tursilion/skunk_pcbs/pcb3/pcb/usb-fx2-r2-bot.jpg

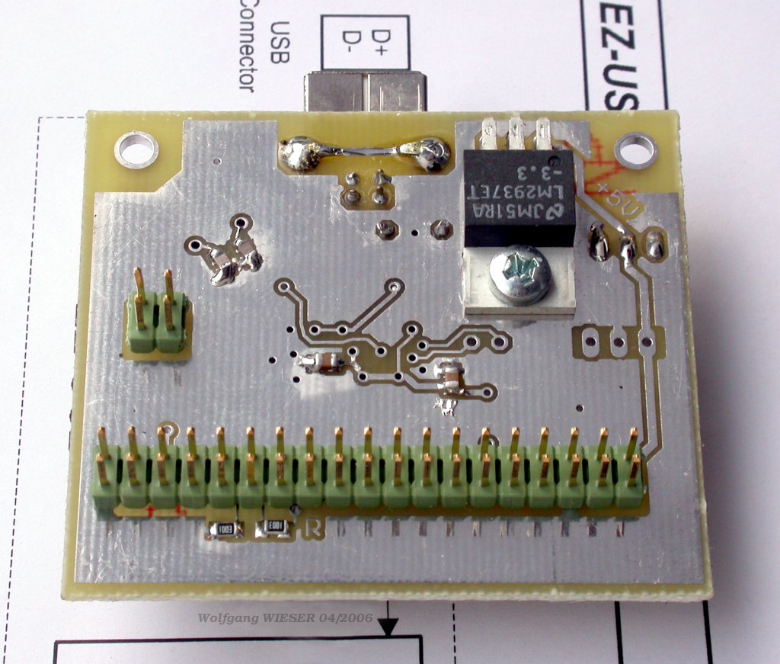
pcb3/pcb/usb-fx2-r2-bot.jpg
