tursilion/skunk_pcbs/pcb3/pcb/area-off/board_outline.png

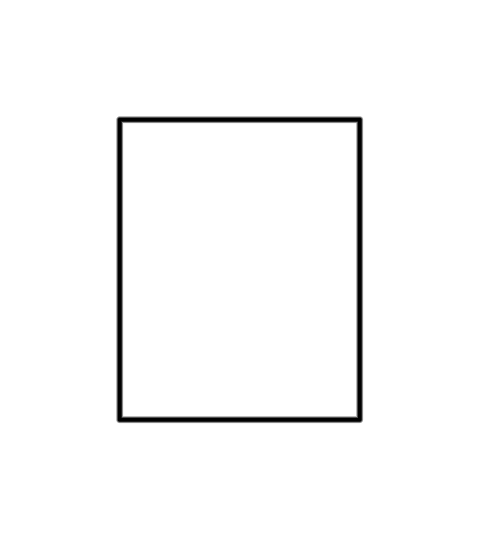
pcb3/pcb/area-off/board_outline.png
