tursilion/skunk_pcbs/pcb3/pcb/area-off/top_copper.png

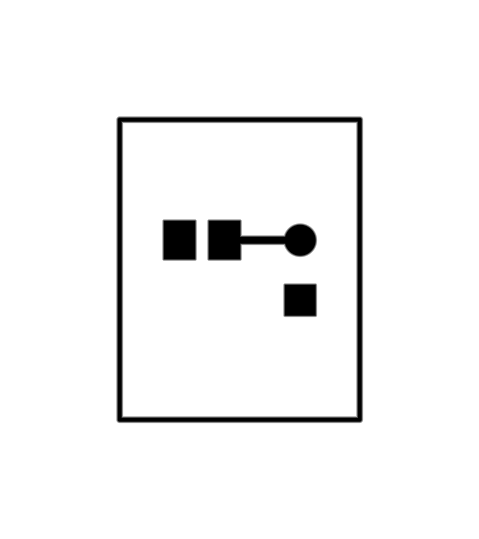
pcb3/pcb/area-off/top_copper.png
