tursilion/skunk_pcbs/pcb3/pcb/area-on/areaboardhouse.gif

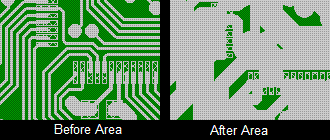
pcb3/pcb/area-on/areaboardhouse.gif
