tursilion/skunk_pcbs/pcb3/pcb/area-on/areaviewmate.gif

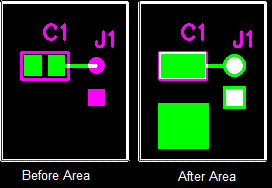
pcb3/pcb/area-on/areaviewmate.gif
