tursilion/skunk_pcbs/pcb3/pcb/area-on/top_copper.png

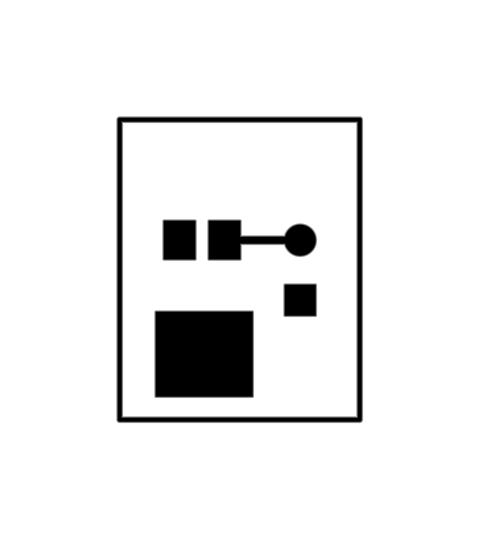
pcb3/pcb/area-on/top_copper.png
