tursilion/skunk_pcbs/pcb3/pcb/jagwave/CAM/board_outline.png

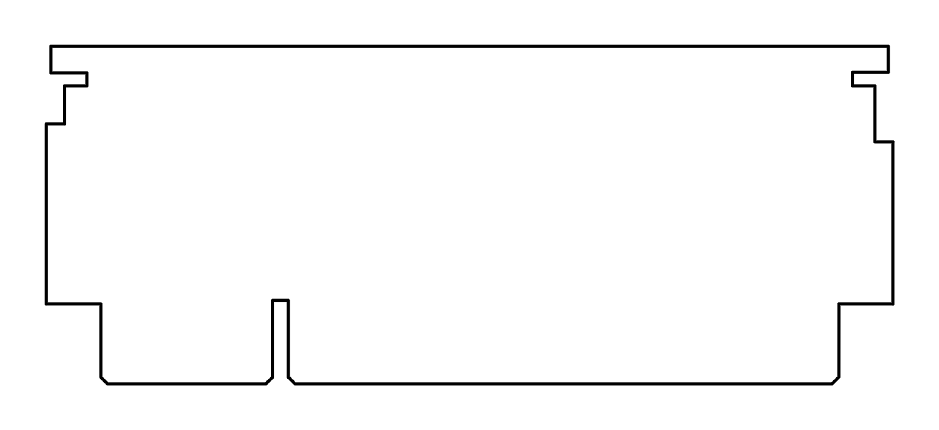
pcb3/pcb/jagwave/CAM/board_outline.png
