tursilion/skunk_pcbs/pcb3/pcb/jagwave/CAM/bottom_copper.png

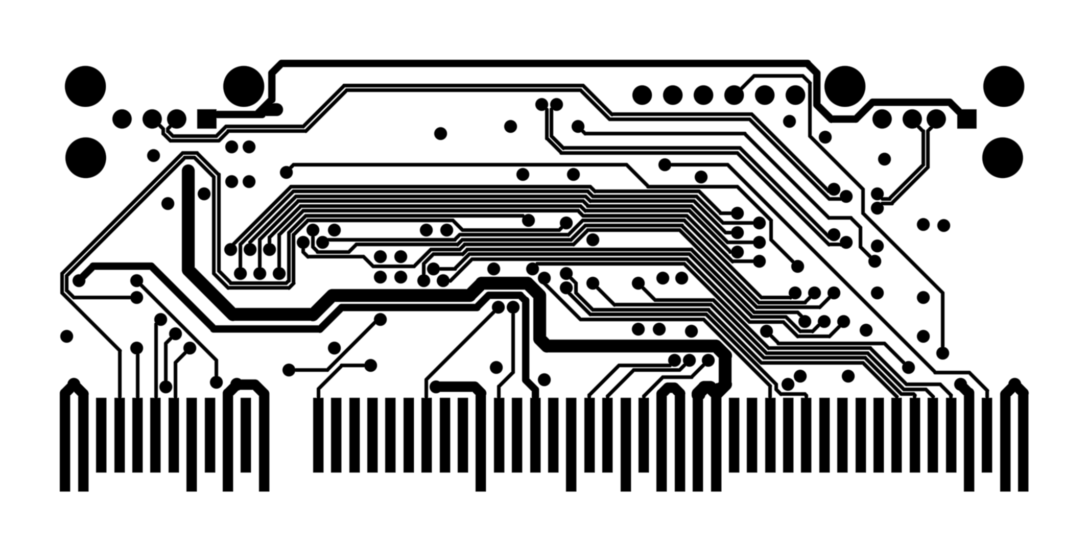
pcb3/pcb/jagwave/CAM/bottom_copper.png
