tursilion/skunk_pcbs/pcb3/pcb/jagwave/CAM/bottom_paste_mask.png

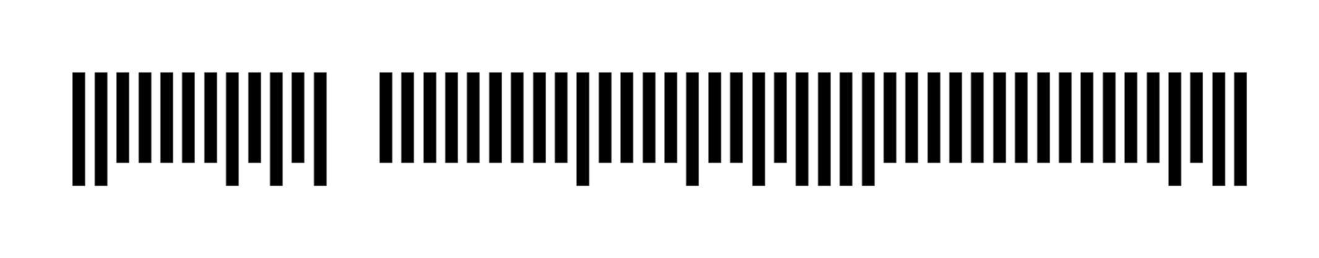
pcb3/pcb/jagwave/CAM/bottom_paste_mask.png
