tursilion/skunk_pcbs/pcb3/pcb/jagwave/CAM/bottom_silk.png

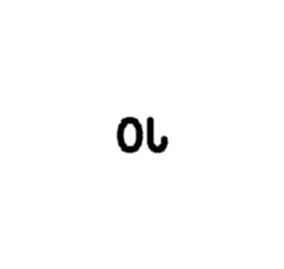
pcb3/pcb/jagwave/CAM/bottom_silk.png
