tursilion/skunk_pcbs/pcb3/pcb/jagwave/CAM/inner_copper_2.png

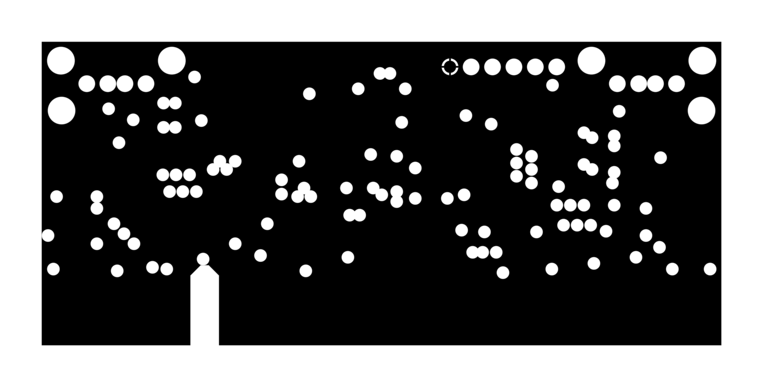
pcb3/pcb/jagwave/CAM/inner_copper_2.png
