tursilion/skunk_pcbs/pcb3/pcb/jagwave/CAM/top_copper.png

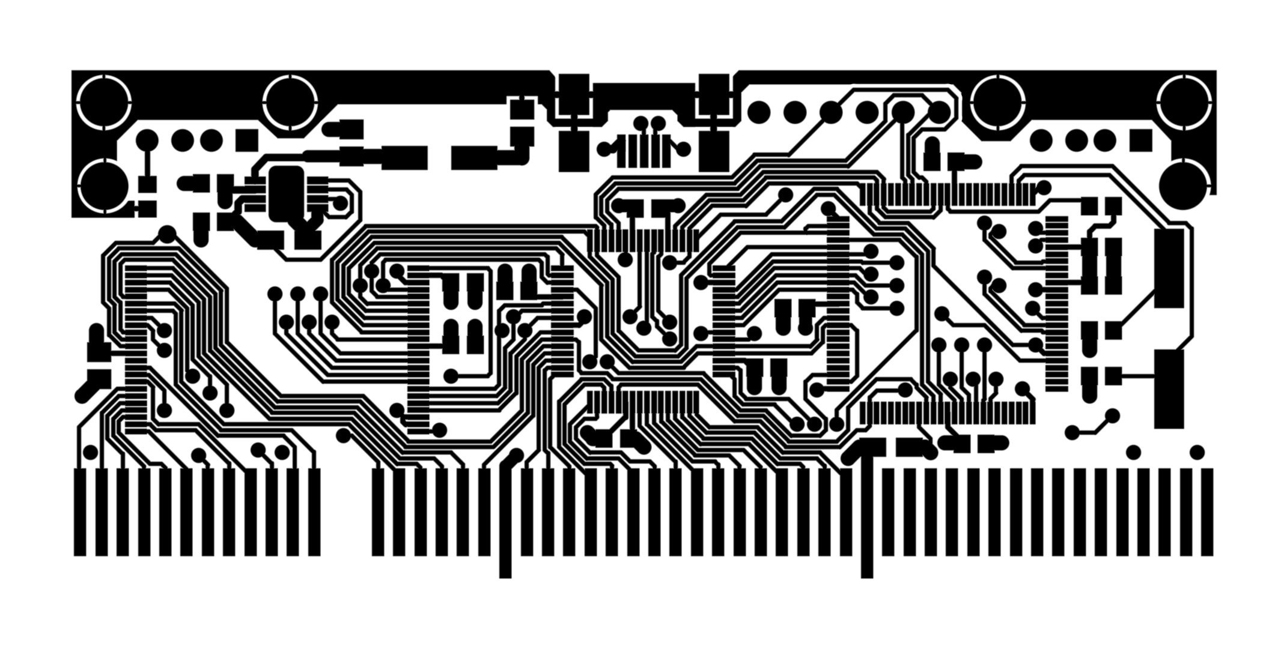
pcb3/pcb/jagwave/CAM/top_copper.png
