tursilion/skunk_pcbs/pcb3/pcb/jagwave/CAM/top_paste_mask.png

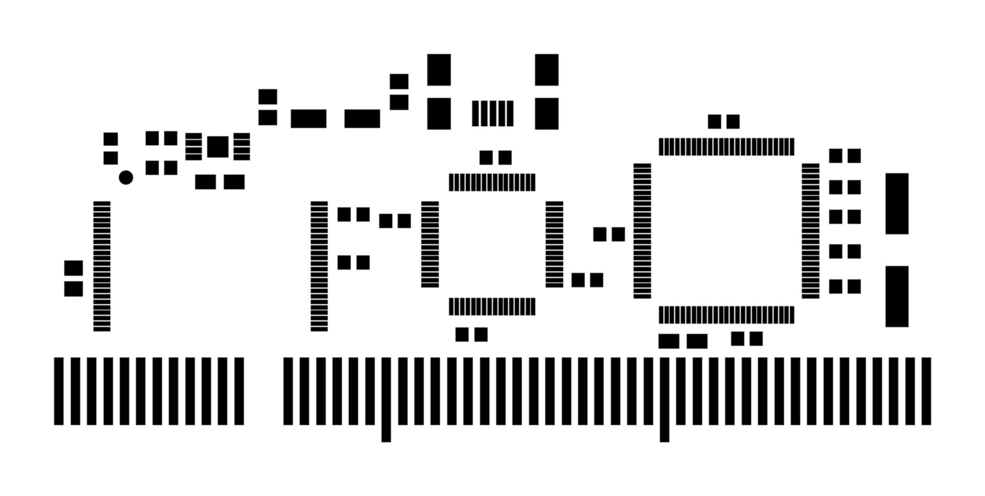
pcb3/pcb/jagwave/CAM/top_paste_mask.png
