tursilion/skunk_pcbs/pcb3/pcb/jagwave/CAM/top_silk.png

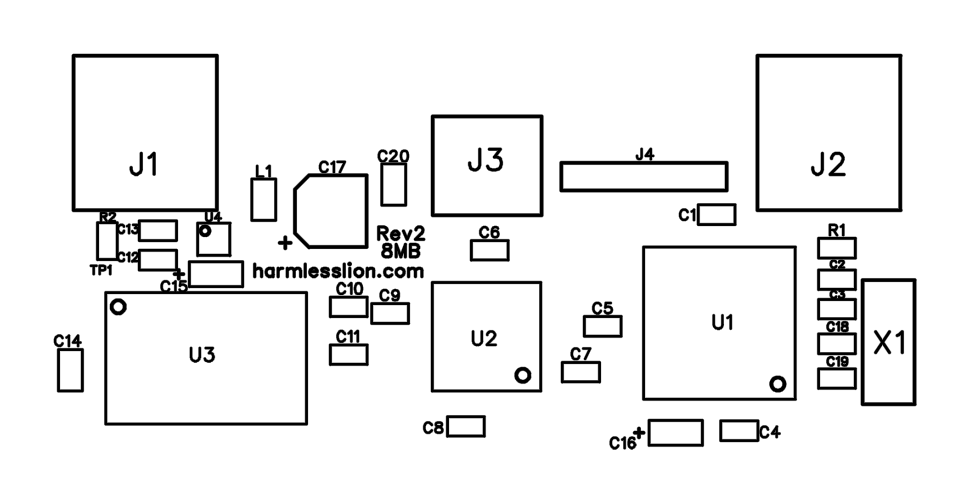
pcb3/pcb/jagwave/CAM/top_silk.png
