tursilion/skunk_pcbs/pcb3/bom.xls

Reference | Qty | Package | Description | DigiKey Part Number | Mfr Part Number | Available | Price (@100) | Needed | Total |  | Already Got | Digikey | Mouser | ACTUAL
DIGIKEY
C1-C13 | 13 | C0603 | CAP CER .1UF 16V 10% X7R 0603 | 490-1532-1-ND | GRM188R71C104KA01D | 646748 | $1.04 | 1300
 | 13 | C0603 | CAP CER .1UF 16V 10% X7R 0603 | 81-GRM39X104K16 | GRM188R71C104KA01D | 758856 | $2.40 | 1300 | $31.20 | Mouser |  |  | $14.63 | $14.63
C14 | 1 | C0805 | CAP CERAMIC 1UF 25V X5R 0805 | PCC2319CT-ND | ECJ-2FB1E105K | 0 |  |  |  | Cross Reference: Mfr: C2012X5R1E105K
 |  |  |  | 445-1419-1-ND | C2012X5R1E105K | 339280 | $9.75 | 100 |  | Thinner, otherwise looks the same
 | 1 | C0805 | CAP CERAMIC 1UF 25V X5R 0805 | 810-C2012X5R1E105K | ECJ-2FB1E105K | 31108 | $9.70 | 100 | $9.70 | Mouser |  |  | $18.48 | $18.48
C15, C16 | 2 | CAP-TANT-A | CAP TANTALUM 10UF 16V 10% SMD | 495-2236-1-ND | B45196H3106K109 | 468976 | $29.70 | 200
 | 2 | CAP-TANT-A | CAP TANTALUM 10UF 16V 10% SMD | 80-B45196H3106K109 | B45196H3106K109 | 112519 | $17.80 | 200 | $35.60 | Mouser |  |  | $41.14 | $41.14
C17 | 1 | CAP-SMT-CAN-D | CAP 150UF 10V ELECT MVA SMD | 565-2076-1-ND | EMVA100ADA151MF55G | 0 |  |  |  | Cross Reference: Mfr: EEE-FK1A151P
 |  |  |  | PCE3773CT-ND | EEE-FK1A151P | 231640 | $30.41 | 100 |  | Taller + different specs! RE-CHECK DATASHEET!
 | 1 | CAP-SMT-CAN-D | CAP 150UF 10V ELECT MVA SMD | 667-EEE-FK1A151P | EMVA100ADA151MF55G | 2200 | $23.80 | 100 | $23.80 | Mouser (slightly more, but original part) |  |  | $40.37 | $40.37
C18, C19 | 2 | C0603 | CAP CERAMIC 22PF 50V 0603 SMD | PCC220ACVCT-ND | ECJ-1VC1H220J | 0 |  |  |  | Cross Reference: Mfr: 06035A220JAT2A
 |  |  |  | 478-1167-1-ND | 06035A220JAT2A | 208810 | $4.23 | 200
 | 2 | C0603 | CAP CERAMIC 22PF 50V 0603 SMD | 581-06035A220J | ECJ-1VC1H220J | 57150 | $2.00 | 200 | $4.00 | Mouser |  |  | $14.52 | $14.52
C20 | 1 | C0805 | CAP CER 4700PF 250V X7R 10% 0805 | 445-2279-1-ND | C2012X7R2E472K | 66600 | $9.10 | 100
 | 1 | C0805 | CAP CER 4700PF 250V X7R 10% 0805 | 810-C2012X7R2E472K | C2012X7R2E472K | 11960 | $9.70 | 100 | $9.70 | Mouser |  |  | $19.25 | $19.25
J1, J2 | 2 | USB-A PTH | CONN RCPT USB TYPE A R/A PCB | 609-1045-ND | 87520-0010BLF | 32136 | $43.10 | 200
 | 2 | USB-A PTH | CONN RCPT USB TYPE A R/A PCB | 649-87520-0010BLF | 87520-0010BLF | 2265 | $43.00 | 200 | $86.00 | Mouser |  |  | $90.20 | $90.20
J3 | 1 | MINIUSB-B SMD | CONN RECEPT MINIUSB R/A 5POS SMD | WM17116CT-ND | 54819-0572 | 20495 | $96.57 | 100 | $96.57 |  |  | $127.80 |  | $127.80
J4 | 1 | MOLEX 6 POS PTH | CONN HEADER 6POS .100 VERT TIN | WM4004-ND | 22-03-2061 | 6677 | $36.90 | 0 |  | Do not stuff
L1 | 1 | C0805 | FERRITE 800MA 120 OHM 0805 SMD | 240-2383-1-ND | LI0805H121R-10 | 385620 | $6.00 | 100 | $6.00 |  |  | $13.60 |  | $13.60
R1 | 1 | C0603 | RES 47K OHM 1/10W 5% 0603 SMD | P47KGCT-ND | ERJ-3GEYJ473V | 2269826 | $0.79 | 100 | $0.79 |  |  | $7.60 |  | $7.60
R2 | 1 | C0805 | RES 1.0M OHM 1/10W 5% 0603 SMD | 541-1.0MGCT-ND | CRCW06031M00JNEA | 90330 | $4.00 | 100
 | 1 | C0805 | RES 1.0M OHM 1/10W 5% 0603 SMD | 71-CRCW0603J-1.0M-E3 | CRCW06031M00JNEA | 70408 | $2.00 | 100 | $2.00 | Mouser |  |  | $9.46 | $9.46
 | 1 | QFP-100-.5-16.0X16.0 | IC USB HOST/PERIPH CNTRL 100TQFP | 428-1865-ND | CY7C67300-100AXI | 267 | $1207.00 | 0 |  | Mouser is almost $300 cheaper though!
U1 |  |  |  | 727-CY7C67300-100AXI | CY7C67300-100AXI | 322 | $944.00 | 100 | $944.00 | This is Mouser's part |  |  | $944.00 | $944.00
U2 | 1 | QFP-64-.5-12.0X12.0 | IC CPLD 1.6K 72MCELL 64-VQFP | 122-1388-ND | XC9572XL-10VQG64C | 4475 | $240.00 | 100 | $240.00 |  |  | $266.00 |  | $266.00
U3 | 1 | GW-48-.5-20.0 | IC FLASH MEM 64MBIT 2.7V 48-TSOP | AT49BV642D-70TU-ND | AT49BV642D-70TU | 0 |  | 100 |  | Not available
 | 1 |  |  |  |  | 100 | $401.51 | 100 | $401.51 | Part already received from Arrow | $401.51 |  |  | $401.51
U4 | 1 | GW-08-.65-4.9 | IC 3.3V LDO/DUAL SWITCH 8-MSOP | 296-13392-5-ND | TPS2159IDGN | 123 | $235.75 | 100 |  | Non-Stock but available
 | 1 | GW-08-.65-4.9 |  |  |  | 100 | $257.56 | 100 | $257.56 | Part already received from DigiKey | $257.56 |  |  | $257.56
X1 | 1 | XTAL-HC49-SMT | CRYSTAL 12.000 MHZ 20PF CSM-7 | XC736CT-ND | ECS-120-20-5PDN-TR | 3185 | $70.20 | 100 | $70.20 |  |  | $94.75 |  | $94.75
 |  |  |  |  |  |  |  |  |  | Reel Fees: |  | $21.00 | $49.00 | $70.00
 |  |  |  |  |  |  |  | TOTAL: | $2218.63 |  | $659.07 | $530.75 | $1241.05 | $2430.87
 |  |  |  |  |  |  |  | Per Board: | $22.19 |  |  | Actual Per Board: |  | $24.31
MOUSER
Reference | Qty | Package | Description | Mouser Part Number | Mfr Part Number | Available | Price (@100) | Needed | Total
C1-C13 | 13 | C0603 | CAP CER .1UF 16V 10% X7R 0603 | 81-GRM39X104K16 | GRM188R71C104KA01D | 758856 | $2.40 | 1300 | $31.20
C14 | 1 | C0805 | CAP CERAMIC 1UF 25V X5R 0805 | 810-C2012X5R1E105K | ECJ-2FB1E105K | 31108 | $9.70 | 100 | $9.70 | Cross Reference: Mfr: C2012X5R1E105K
C15, C16 | 2 | CAP-TANT-A | CAP TANTALUM 10UF 16V 10% SMD | 80-B45196H3106K109 | B45196H3106K109 | 112519 | $17.80 | 200 | $35.60
C17 | 1 | CAP-SMT-CAN-D | CAP 150UF 10V ELECT MVA SMD | 667-EEE-FK1A151P | EMVA100ADA151MF55G | 2200 | $23.80 | 100 | $23.80 | Cross Reference: Mfr: EEE-FK1A151P
C18, C19 | 2 | C0603 | CAP CERAMIC 22PF 50V 0603 SMD | 581-06035A220J | ECJ-1VC1H220J | 57150 | $2.00 | 200 | $4.00 | Cross Reference: Mfr: 06035A220JAT2A
C20 | 1 | C0805 | CAP CER 4700PF 250V X7R 10% 0805 | 810-C2012X7R2E472K | C2012X7R2E472K | 11960 | $9.70 | 100 | $9.70
J1, J2 | 2 | USB-A PTH | CONN RCPT USB TYPE A R/A PCB | 649-87520-0010BLF | 87520-0010BLF | 2265 | $43.00 | 200 | $86.00
J3 | 1 | MINIUSB-B SMD | CONN RECEPT MINIUSB R/A 5POS SMD | 538-54819-0572 | 54819-0572 | 15450 | $106.00 | 100 | $106.00
J4 | 1 | MOLEX 6 POS PTH | CONN HEADER 6POS .100 VERT TIN | 538-22-03-2061 | 22-03-2061 | 7013 | $46.60 | 100 | $46.60
L1 | 1 | C0805 | FERRITE 800MA 120 OHM 0805 SMD | 875-LI0805H121R-10 | LI0805H121R-10 | 13030 | $6.50 | 100 | $6.50
R1 | 1 | C0603 | RES 47K OHM 1/10W 5% 0603 SMD | 667-ERJ-3GEYJ473V | ERJ-3GEYJ473V | 119537 | $0.70 | 100 | $0.70
R2 | 1 | C0805 | RES 1.0M OHM 1/10W 5% 0603 SMD | 71-CRCW0603J-1.0M-E3 | CRCW06031M00JNEA | 70408 | $2.00 | 100 | $2.00
U1 | 1 | QFP-100-.5-16.0X16.0 | IC USB HOST/PERIPH CNTRL 100TQFP | 727-CY7C67300-100AXI | CY7C67300-100AXI | 322 | $944.00 | 100 | $944.00 | $300 cheaper than digikey - $3/board!
U2 | 1 | QFP-64-.5-12.0X12.0 | IC CPLD 1.6K 72MCELL 64-VQFP |  | XC9572XL-10VQG64C |  |  | 100 | $0.00
U3 | 1 | GW-48-.5-20.0 | IC FLASH MEM 64MBIT 2.7V 48-TSOP | 556-AT49BV642D70TU | AT49BV642D-70TU | 0 |  | 100 | $0.00
U4 | 1 | GW-08-.65-4.9 | IC 3.3V LDO/DUAL SWITCH 8-MSOP | TPS2159IDGN | TPS2159IDGN | 60 | $233.00 | 100 | $233.00 | Not enough available
X1 | 1 | XTAL-HC49-SMT | CRYSTAL 12.000 MHZ 20PF CSM-7 |  | ECS-120-20-5PDN-TR |  |  | 100 | $0.00
 |  |  |  |  |  |  |  | TOTAL: | $1538.80
 |  |  |  |  |  |  |  | Per Board: | $15.39
JAMECO
Reference | Qty | Package | Description | Jameco Part Number | Mfr Part Number | Available | Price (@100) | Needed | Total
C1-C13 | 13 | C0603 | CAP CER .1UF 16V 10% X7R 0603 | 544091 | GRM188R71C104KA01D |  | $0.99 | 1300 | $12.87 | $1 cheaper than Digikey (1c per board)
C14 | 1 | C0805 | CAP CERAMIC 1UF 25V X5R 0805 |  | ECJ-2FB1E105K |  |  |  |  | Cross Reference: Mfr: C2012X5R1E105K
 |  |  |  |  | C2012X5R1E105K | 0 |  | 100 | $0.00 | Thinner, otherwise looks the same
C15, C16 | 2 | CAP-TANT-A | CAP TANTALUM 10UF 16V 10% SMD |  | B45196H3106K109 | 0 |  | 200 | $0.00
C17 | 1 | CAP-SMT-CAN-D | CAP 150UF 10V ELECT MVA SMD |  | EMVA100ADA151MF55G |  |  |  |  | Cross Reference: Mfr: EEE-FK1A151P
 |  |  |  | 1984179 | EEE-FK1A151P |  | $19.00 | 100 | $19.00 | $10 cheaper than digikey, 10c per board.
C18, C19 | 2 | C0603 | CAP CERAMIC 22PF 50V 0603 SMD |  | ECJ-1VC1H220J |  |  |  |  | Cross Reference: Mfr: 06035A220JAT2A
 |  |  |  |  | 06035A220JAT2A |  | $0.99 | 200 | $1.98 | $6 cheaper than Digikey, but that's only 6c per board
C20 | 1 | C0805 | CAP CER 4700PF 250V X7R 10% 0805 |  | C2012X7R2E472K | 0 |  | 100 | $0.00
J1, J2 | 2 | USB-A PTH | CONN RCPT USB TYPE A R/A PCB |  | 87520-0010BLF | 0 |  | 200 | $0.00
J3 | 1 | MINIUSB-B SMD | CONN RECEPT MINIUSB R/A 5POS SMD |  | 54819-0572 | 800 min | $680.00 | 100 | $680.00 | Min quantity too high
J4 | 1 | MOLEX 6 POS PTH | CONN HEADER 6POS .100 VERT TIN |  | 22-03-2061 |  | $29.00 | 100 | $29.00 | May omit
L1 | 1 | C0805 | FERRITE 800MA 120 OHM 0805 SMD |  | LI0805H121R-10 | 0 |  | 100 | $0.00
R1 | 1 | C0603 | RES 47K OHM 1/10W 5% 0603 SMD |  | ERJ-3GEYJ473V | 5000 min | $30.00 | 100 | $30.00
R2 | 1 | C0805 | RES 1.0M OHM 1/10W 5% 0603 SMD |  | CRCW06031M00JNEA | 0 |  | 100 | $0.00
U1 | 1 | QFP-100-.5-16.0X16.0 | IC USB HOST/PERIPH CNTRL 100TQFP |  | CY7C67300-100AXI | 0 |  | 100 | $0.00
U2 | 1 | QFP-64-.5-12.0X12.0 | IC CPLD 1.6K 72MCELL 64-VQFP |  | XC9572XL-10VQG64C | 0 |  | 100 | $0.00
U3 | 1 | GW-48-.5-20.0 | IC FLASH MEM 64MBIT 2.7V 48-TSOP |  | AT49BV642D-70TU | 0 |  | 100 | $0.00
U4 | 1 | GW-08-.65-4.9 | IC 3.3V LDO/DUAL SWITCH 8-MSOP |  | TPS2159IDGN | 0 |  | 100 | $0.00
X1 | 1 | XTAL-HC49-SMT | CRYSTAL 12.000 MHZ 20PF CSM-7 |  | ECS-120-20-5PDN-TR | 97 | $39.00 | 100 | $39.00 | not enough
 |  |  |  |  |  |  |  | TOTAL: | $811.85
 |  |  |  |  |  |  |  | Per Board: | $8.12
