tursilion/skunk_pcbs/pcb3/pcb/bom_SMT.pdf

# bom.BMB 11/11/2008 www.aapcb.com

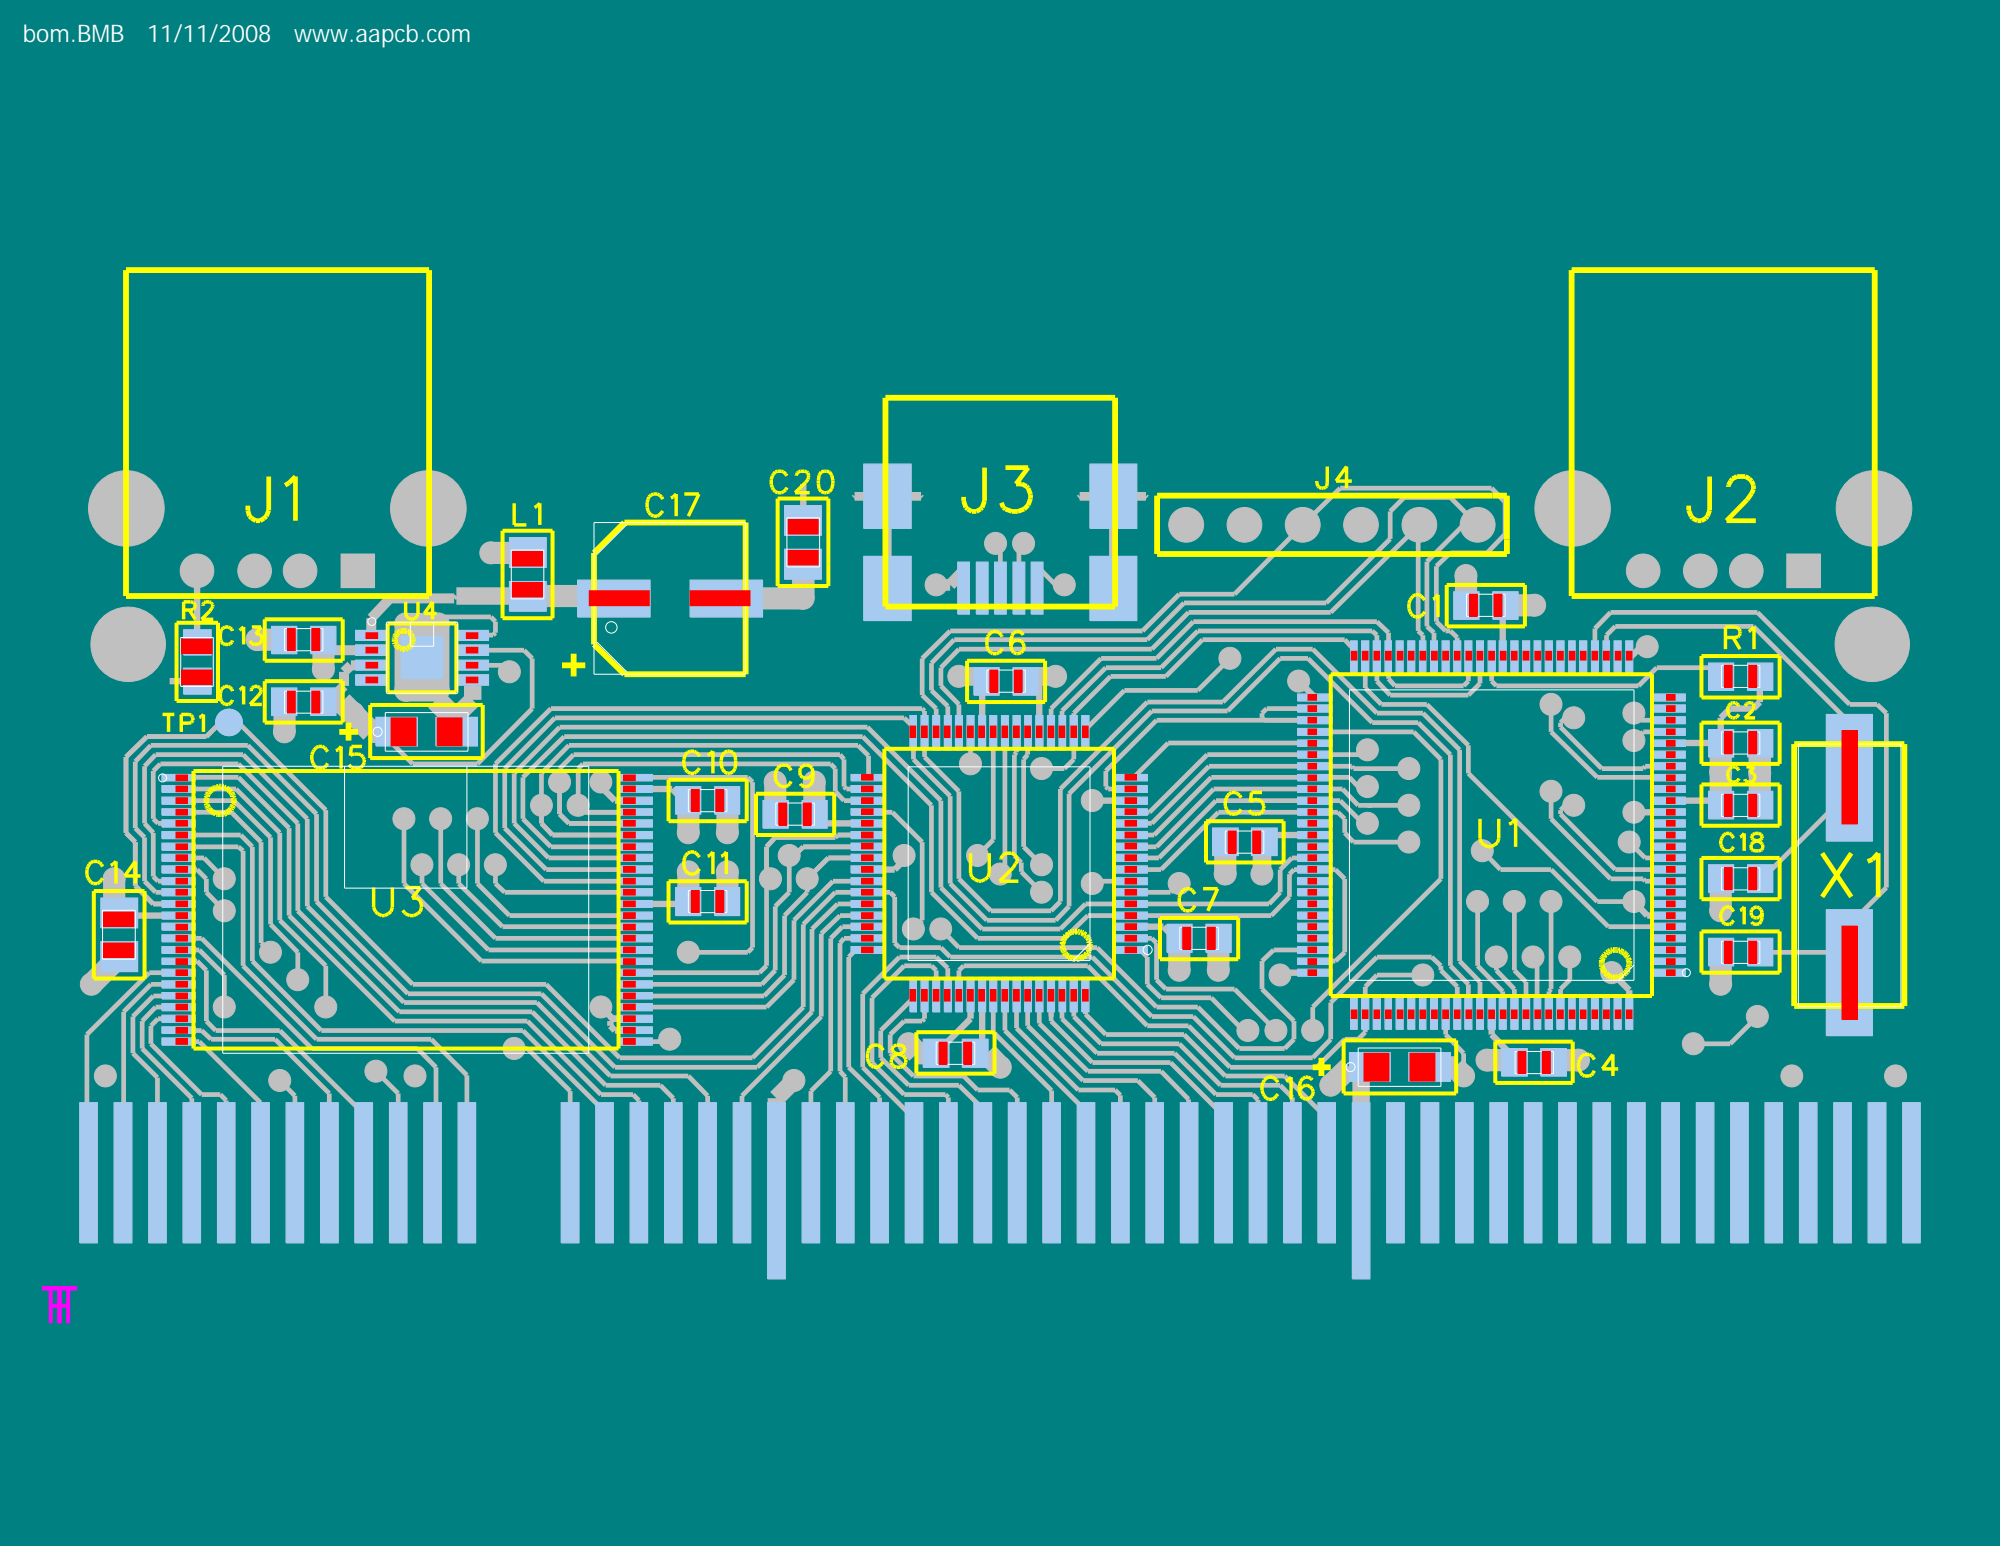
[picture p19: page 1]
