tursilion/skunk_pcbs/pcb3/pcb/jagwave/assembly.pdf

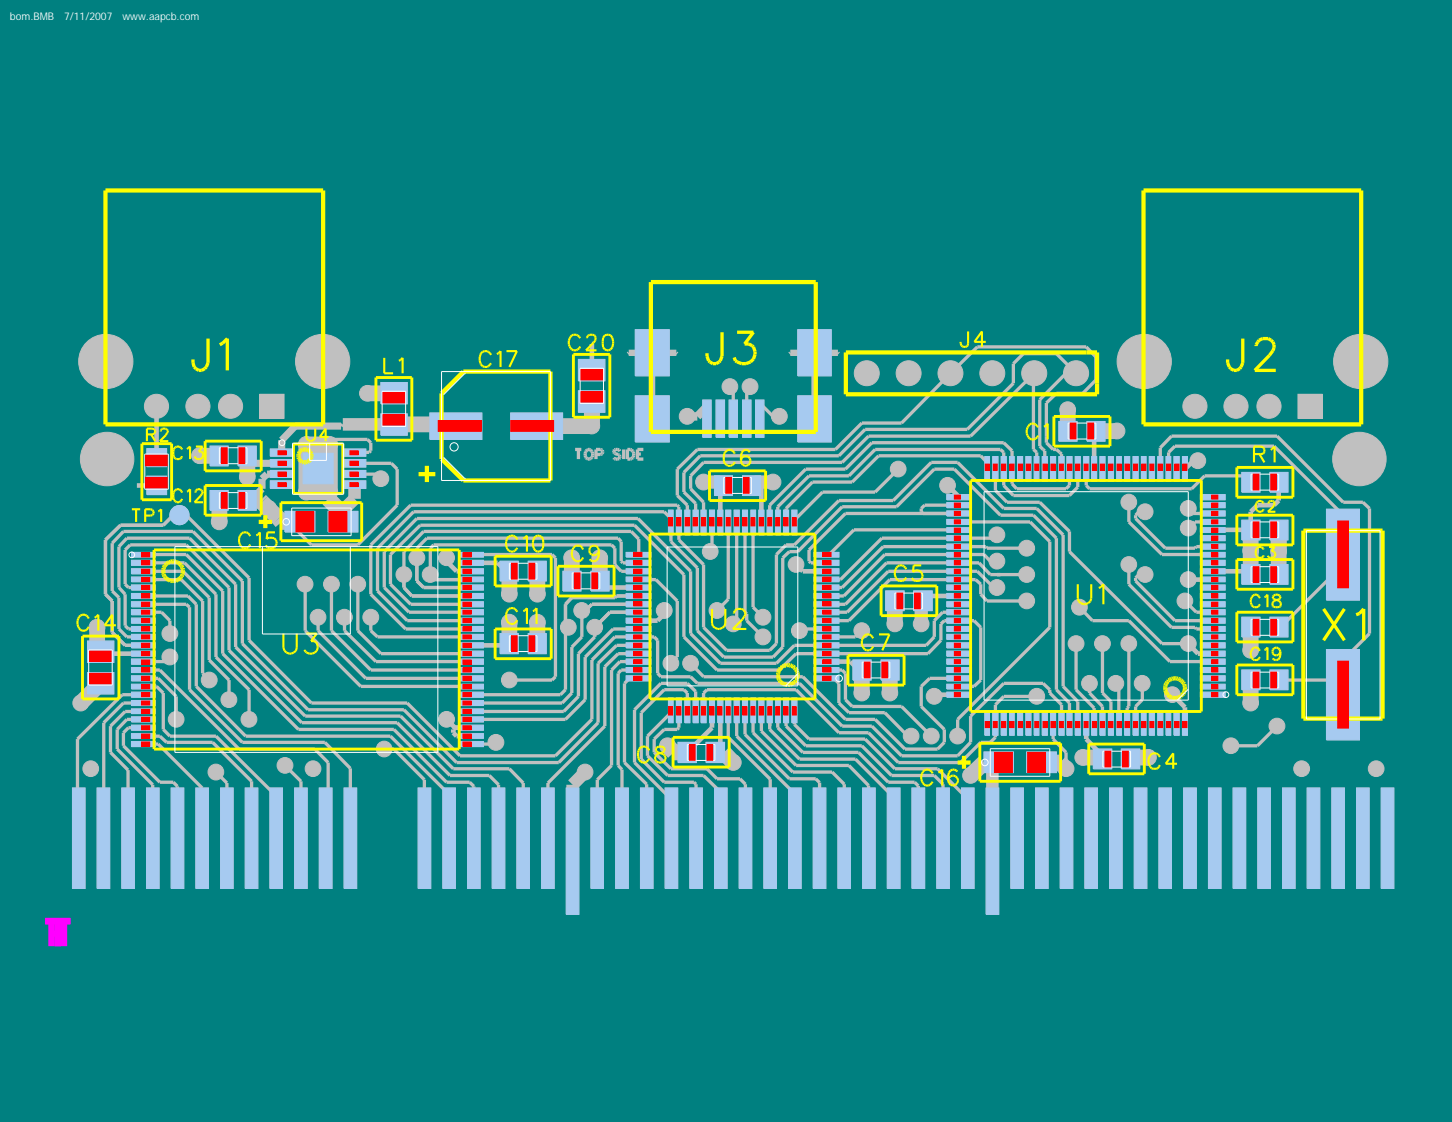
[picture p20: page 1]

bom.BMB 7/11/2007 www.aapcb.com
