tursilion/skunk_pcbs/pcb2/assembly.pdf

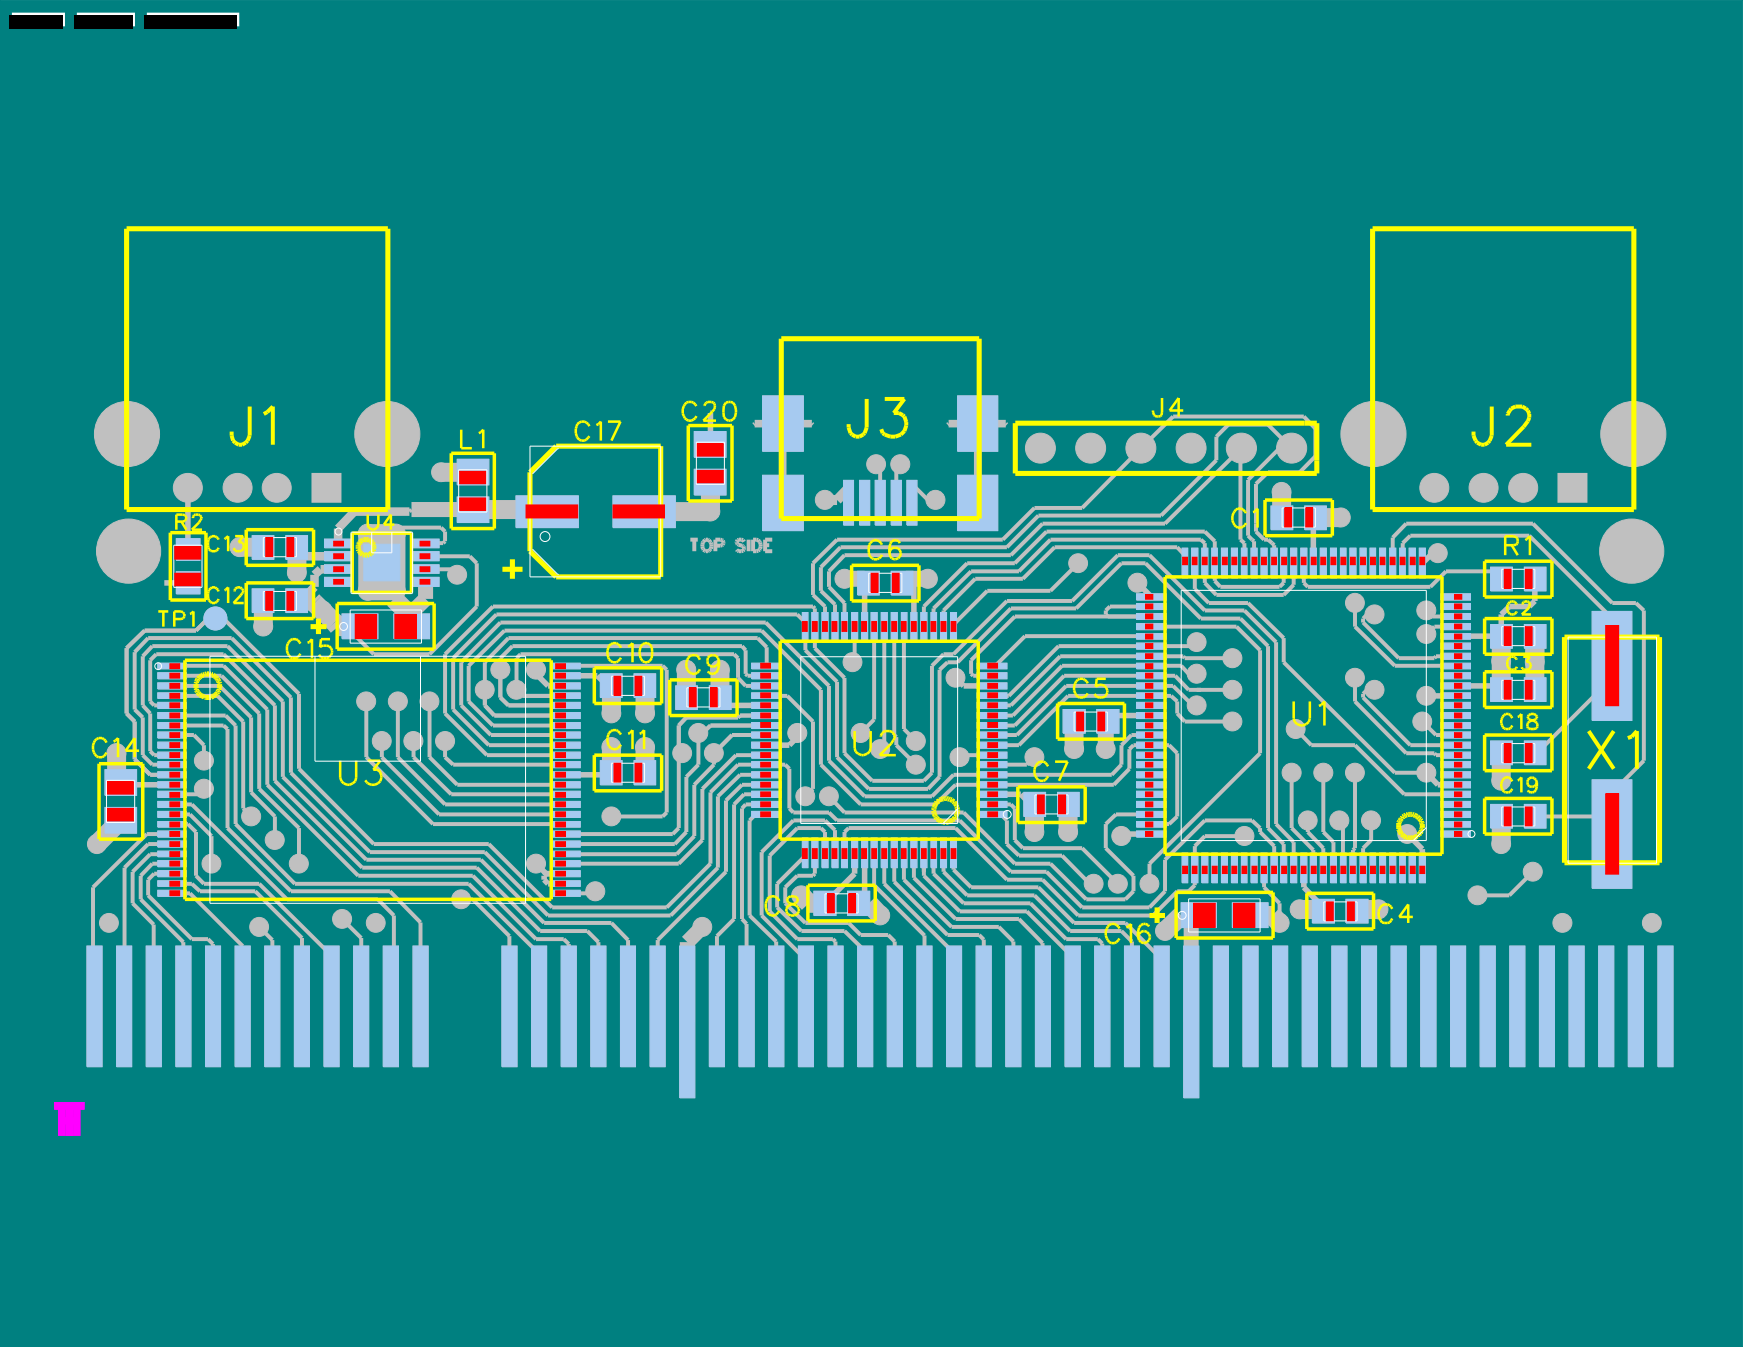
[picture p21: page 1]
