tursilion/skunk_pcbs/(list of files, drawings)

Other design files:
pcb3/pcb/jagwave.dsn
pcb3/pcb/jagwave/jagwave-scratch.dsn
pcb3/pcb/jagwave/redo.dsn
