tursilion/skunk_pcbs/(commit log)

2018-09-08 first commit for github
    [bom.CSV, bom.csv, bom.xls, bom.xlsx, centroid.csv, jagwave-scratch.dsn, jagwave.dsn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]
2020-10-16 - add apology for lack of schematic PDF
